fraufrau31/USB-C-Power-Meter/HW/Manufacturing/usb-c-power-meter-BOM.xlsx

Reference | Value | Description | Footprint | Qty | DNP | Mfr. No | DIGIKEY | FARNELL | MOUSER
C1,C2,C4,C6 | 100nF | C Ceramic, 100nF, 16V, ±10%, 0603 | Capacitor_SMD:C_0603_1608Metric | 4 |  | CC0603KRX7R7BB104 | 311-1088-1-ND | 2408501 | 603-CC603KRX7R7BB104
C3 | 10uF | C Ceramic, 10uF, 50V, ±10%, 1206 | Capacitor_SMD:C_1206_3216Metric | 1 |  | CL31A106KBHNNNE | 1276-2876-1-ND | 3013512 | 187-CL31A106KBHNNNE
C5 | 10uF | C Ceramic, 10uF, 16V, ±10%, 0805 | Capacitor_SMD:C_0805_2012Metric | 1 |  | CL21A106KOQNNNE | 1276-1096-1-ND | 3013453 | 187-CL21A106KOQNNNE
D1,D2 | BAT854CW | Dual Schottky diode, common anode on pin 1 | Package_TO_SOT_SMD:SOT-323_SC-70 | 2 |  | BAT854CW | 1727-1211-1-ND | 3912169 | 771-BAT854CW,135
D3 | BAT54GW | 30 V, 200 mA Schottky barrier diodes | Diode_SMD:D_SOD-123 | 1 |  | BAT54GWJ | 1727-7328-1-ND | 3439596 | 841-BAT54GWJ
J1,J2,J4 | USB4110 | Type C USB 2.0 Connector | Connector_USB:USB_C_Receptacle_GCT_USB4110 | 3 |  | USB4110-GF-A | 2073-USB4110-GF-A-1-ND | 3588206 | 640-USB4110-GF-A
J3 | Conn_01x04_Pin | Generic connector, single row, 01x04, script generated | Connector_PinHeader_2.54mm:PinHeader_1x04_P2.54mm_Vertical | 1 | DNP
R1,R2 | 5,1k | R, 5,1kOhms, ±1%, 0.1W, 1/10W, 0603 | Resistor_SMD:R_0603_1608Metric | 2 |  | RC0603FR-075K1L | 311-5.10KHRCT-ND | 3495881 | 603-RC0603FR-075K1L
R3,R4 | 27 | R, 27Ohms, ±1%, 0.1W, 1/10W, 0603 | Resistor_SMD:R_0603_1608Metric | 2 |  | RC0603FR-0727RL | 311-27.0HRCT-ND | 9238298 | 603-RC0603FR-0727RL
R5,R6,R7 | 10k | R, 10kOhms, ±1%, 0.1W, 1/10W, 0603 | Resistor_SMD:R_0603_1608Metric | 3 |  | RC0603FR-0710KL | 311-10.0KHRCT-ND | 9238603 | 603-RC0603FR-0710KL
R8 | 3,3k | R, 3,3kOhms, ±1%, 0.1W, 1/10W, 0603 | Resistor_SMD:R_0603_1608Metric | 1 |  | RC0603FR-073K3L | 311-3.30KHRCT-ND | 9238549 | 603-RC0603FR-073K3L
R9 | 0 | R, 0Ohms, ±1%, 0.1W, 1/10W, 0603 | Resistor_SMD:R_0603_1608Metric | 1 |  | RC0603JR-070RL | 311-0.0GRCT-ND | 9233130 | 603-RC0603JR-070RL
U1 | FT230XS | Full Speed USB to Basic UART, SSOP-16 | Package_SO:SSOP-16_3.9x4.9mm_P0.635mm | 1 |  | FT230XS-R | 768-1135-1-ND | 2081321 | 895-FT230XS-R
U2 | TLV709A33DBV | TLV709 150mA, 30V, 3.2μA Quiescent Current, Low-Dropout Linear Regulator | Package_TO_SOT_SMD:SOT-23-5 | 1 |  | TLV709A33DBV | 296-TLV709A33DBVRCT-ND | # | 595-TLV709A33DBVR
U3 | INA700AYWFR | 40-V 16-Bit I²C output digital power monitor in WCSP with EZShunt™ Technology | usb-c-power-meter:YWF0008A | 1 |  | INA700AYWFR | 296-INA700AYWFRCT-ND | # | 595-INA700AYWFR
U4 | ATtiny202-SS | 20MHz, 2kB Flash, 128B SRAM, 64B EEPROM, SOIC-8 | Package_SO:SOIC-8_3.9x4.9mm_P1.27mm | 1 |  | ATTINY202-SSFR | ATTINY202-SSFRCT-ND | 3630362 | 579-ATTINY202-SSFR
