fraufrau31/USB-C-Power-Meter/HW/3D/USB4110-GF-A.stp

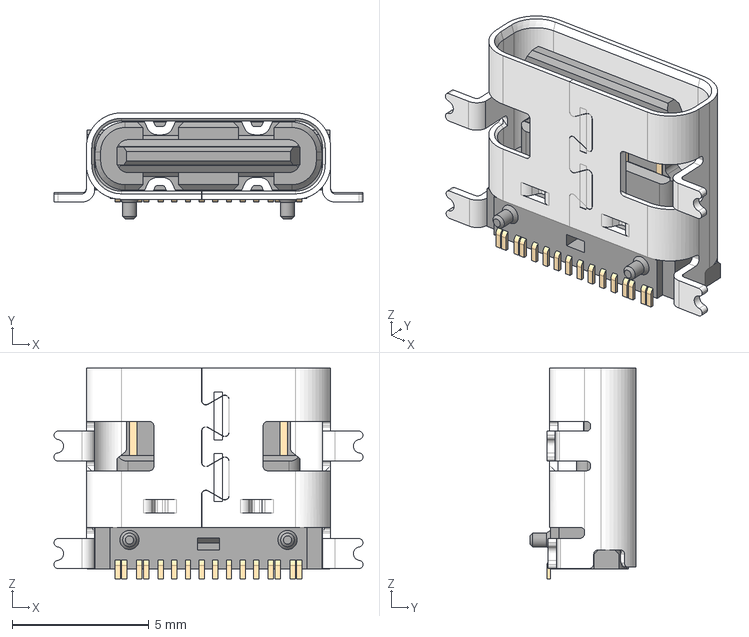
[picture p3: CAD file, 2024-12-28]
HW/3D/USB4110-GF-A.stp
11.3 x 3.89 x 7.70 mm
