fraufrau31/USB-C-Power-Meter/HW/3D/YWF0008A.stp

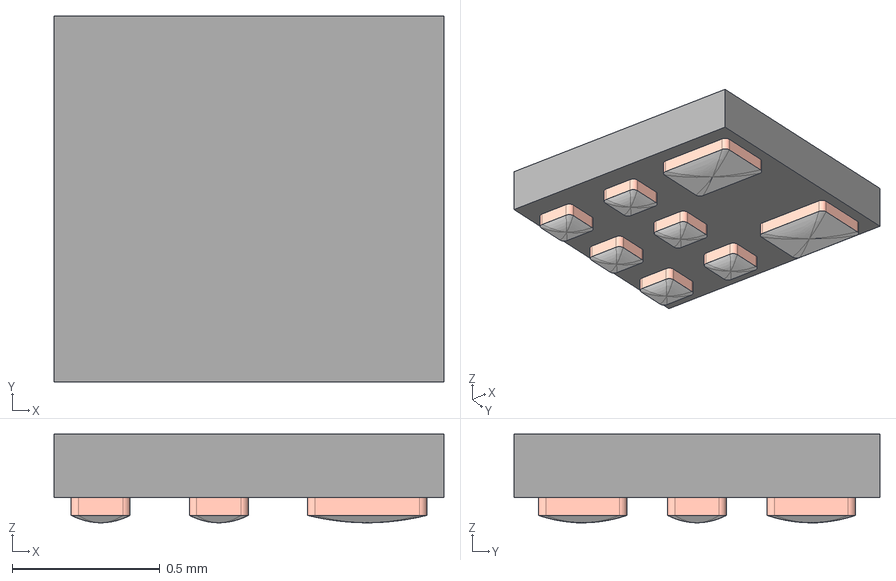
[picture p4: CAD file, 2024-12-28]
HW/3D/YWF0008A.stp
1.32 x 1.24 x 0.3 mm
SILICON_YWF0008A
CU_POST_YWF0008A_AF1 x 6
CAP_YWF0008A_AF0 x 6
CU_POST_YWF0008A_AF0 x 2
CAP_YWF0008A_AF1 x 2
