fraufrau31/USB-C-Power-Meter/Documentation/usb-c-power-meter-schematic.pdf

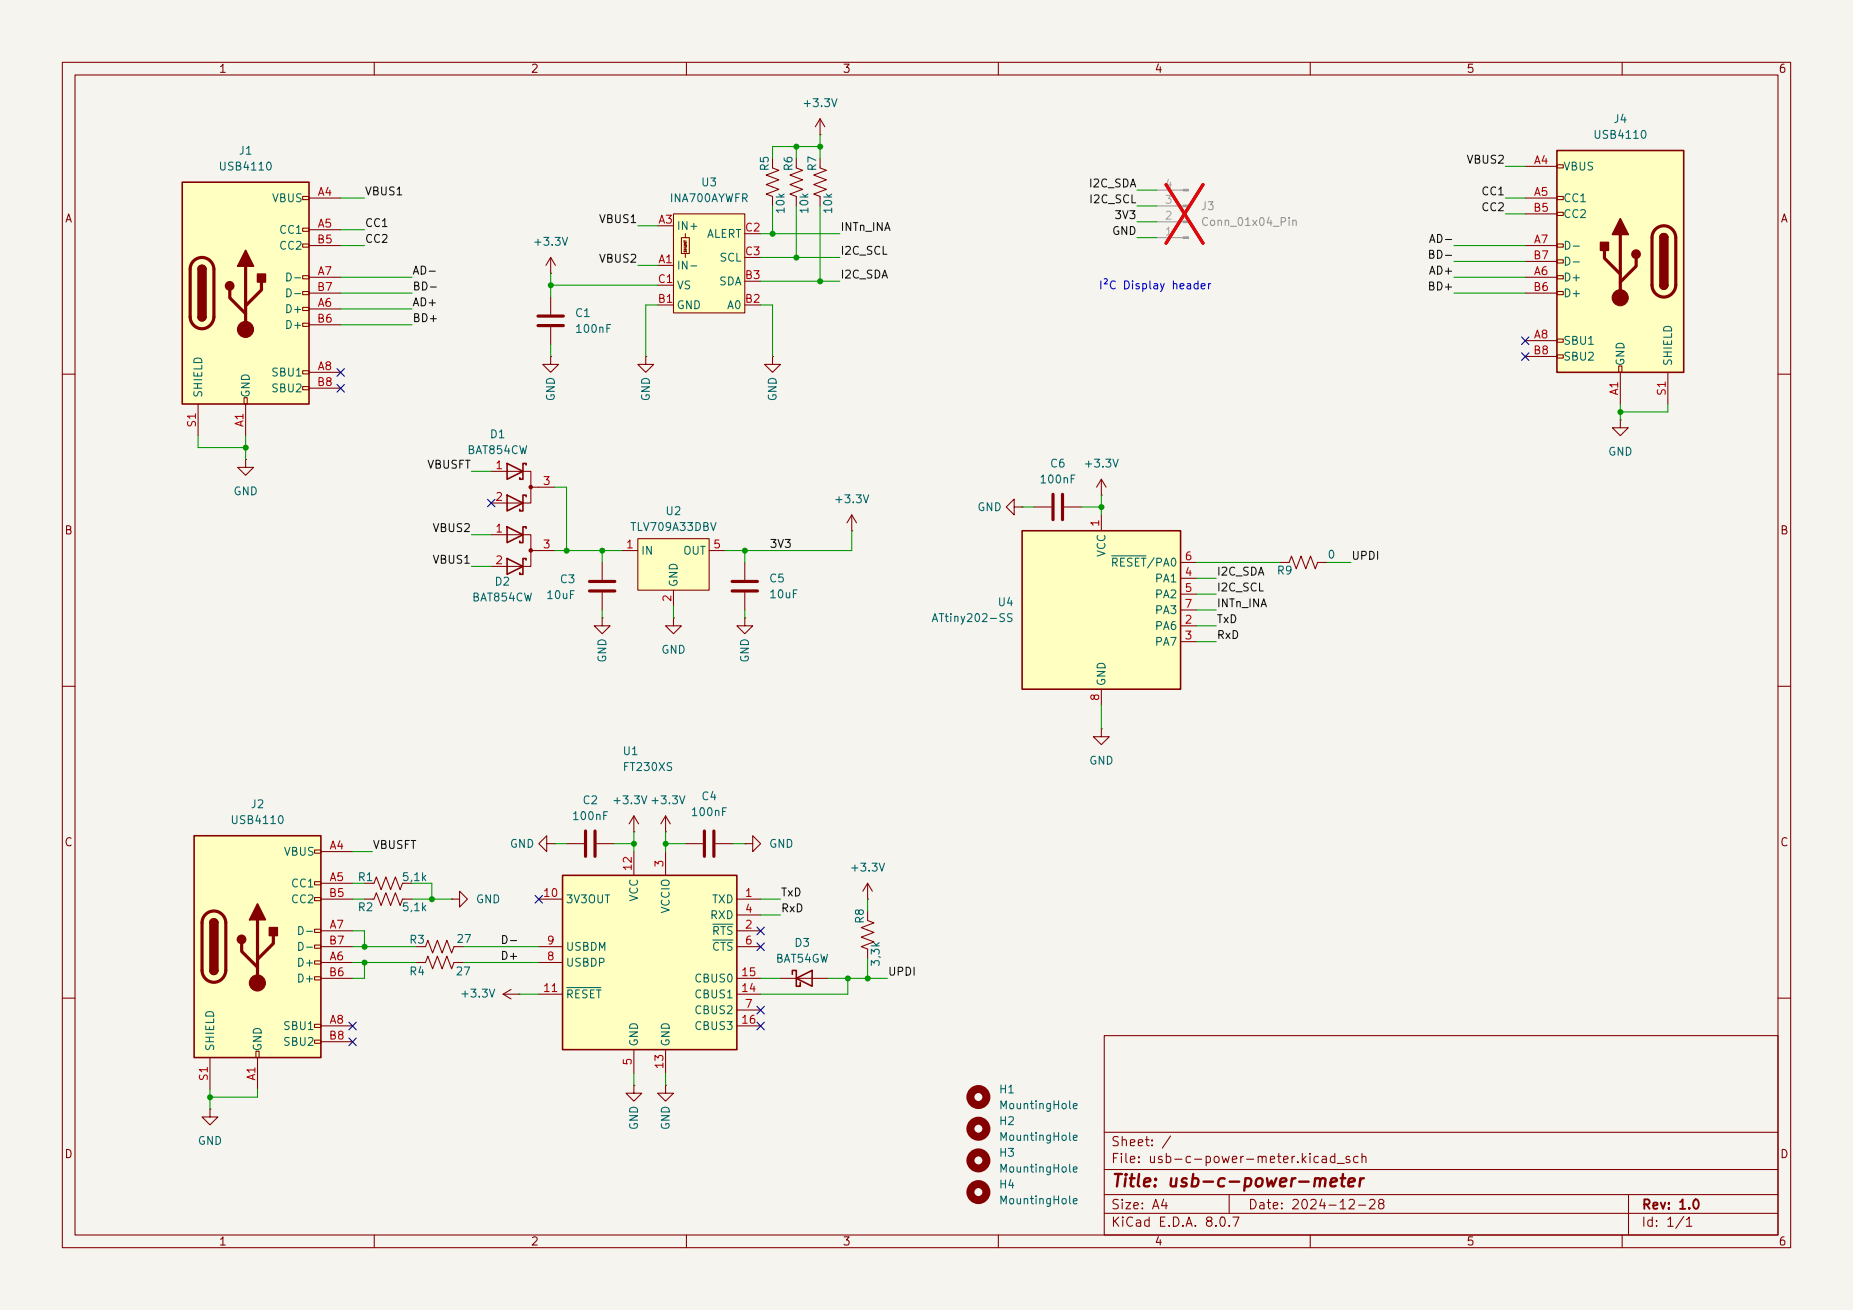
[picture p5: page 1]
