fraufrau31/USB-C-Power-Meter/HW/usb-c-power-meter.kicad_pcb

## KiCad design HW/usb-c-power-meter.kicad_pcb (2024-12-28)

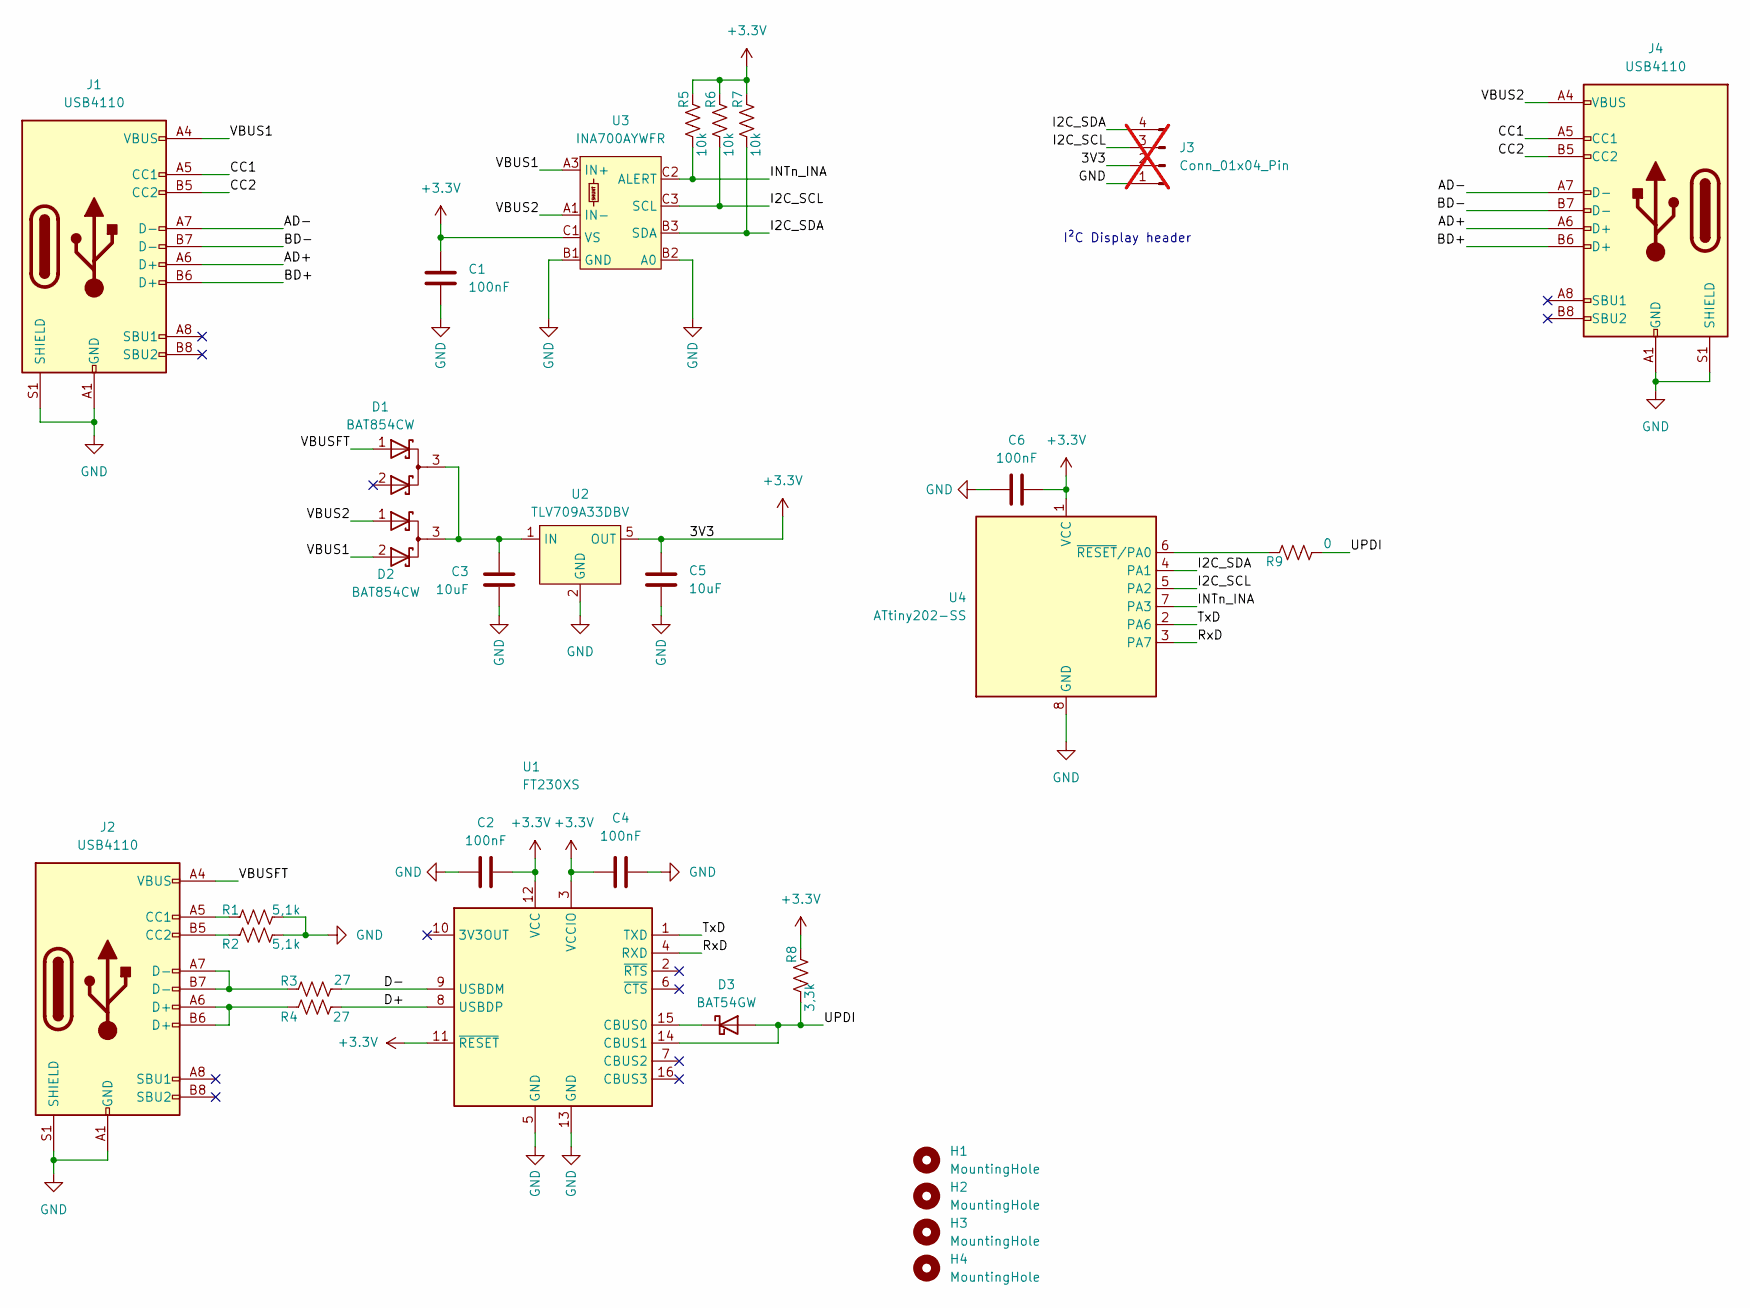
[picture p6: schematic usb-c-power-meter.kicad_sch]

Parts:
C1, C2, C4, C6: 100nF; C_0603_1608Metric; DIGIKEY 311-1088-1-ND
C3: 10uF; C_1206_3216Metric; DIGIKEY 1276-2876-1-ND
C5: 10uF; C_0805_2012Metric; DIGIKEY 1276-1096-1-ND
D1, D2: BAT854CW; SOT-323_SC-70; DIGIKEY 1727-1211-1-ND
D3: BAT54GW; D_SOD-123; DIGIKEY 1727-7328-1-ND
H1, H2, H3, H4: MountingHole; MountingHole_2.2mm_M2
J1, J2, J4: USB4110; USB_C_Receptacle_GCT_USB4110; DIGIKEY 2073-USB4110-GF-A-1-ND
J3: Conn_01x04_Pin; PinHeader_1x04_P2.54mm_Vertical; not fitted
R1, R2: 5,1k; R_0603_1608Metric; DIGIKEY 311-5.10KHRCT-ND
R3, R4: 27; R_0603_1608Metric; DIGIKEY 311-27.0HRCT-ND
R5, R6, R7: 10k; R_0603_1608Metric; DIGIKEY 311-10.0KHRCT-ND
R8: 3,3k; R_0603_1608Metric; DIGIKEY 311-3.30KHRCT-ND
R9: 0; R_0603_1608Metric; DIGIKEY 311-0.0GRCT-ND
U1: FT230XS; SSOP-16_3.9x4.9mm_P0.635mm; DIGIKEY 768-1135-1-ND
U2: TLV709A33DBV; SOT-23-5; DIGIKEY 296-TLV709A33DBVRCT-ND
U3: INA700AYWFR; YWF0008A; DIGIKEY 296-INA700AYWFRCT-ND
U4: ATtiny202-SS; SOIC-8_3.9x4.9mm_P1.27mm; DIGIKEY ATTINY202-SSFRCT-ND

Connections:
+3.3V: C1.1, C2.2, C4.1, C5.1, C6.2, J3.2, R5.2, R6.2, R7.2, R8.2, U1.3 (VCCIO), U1.11 (~RESET), U1.12 (VCC), U2.5 (OUT), U3.C1 (VS), U4.1 (VCC)
/AD+: J1.A6 (D+), J4.A6 (D+)
/AD-: J1.A7 (D-), J4.A7 (D-)
/BD+: J1.B6 (D+), J4.B6 (D+)
/BD-: J1.B7 (D-), J4.B7 (D-)
/CC1: J1.A5 (CC1), J4.A5 (CC1)
/CC2: J1.B5 (CC2), J4.B5 (CC2)
/D+: R4.1, U1.8 (USBDP)
/D-: R3.1, U1.9 (USBDM)
/I2C_SCL: J3.3, R6.1, U3.C3 (SCL), U4.5 (PA2)
/I2C_SDA: J3.4, R7.1, U3.B3 (SDA), U4.4 (PA1)
/INTn_INA: R5.1, U3.C2 (ALERT), U4.7 (PA3)
/RxD: U1.4 (RXD), U4.3 (PA7)
/TxD: U1.1 (TXD), U4.2 (PA6)
/UPDI: D3.2 (A), R8.1, R9.1, U1.14 (CBUS1)
/VBUS1: D2.2 (K), J1.A4 (VBUS), J1.A9 (VBUS), J1.B4 (VBUS), J1.B9 (VBUS), U3.A3 (IN+)
/VBUS2: D2.1 (K), J4.A4 (VBUS), J4.A9 (VBUS), J4.B4 (VBUS), J4.B9 (VBUS), U3.A1 (IN-)
/VBUSFT: D1.1 (K), J2.A4 (VBUS), J2.A9 (VBUS), J2.B4 (VBUS), J2.B9 (VBUS)
GND: C1.2, C2.1, C3.2, C4.2, C5.2, C6.1, J1.A1 (GND), J1.A12 (GND), J1.B1 (GND), J1.B12 (GND), J1.S1 (SHIELD), J2.A1 (GND), J2.A12 (GND), J2.B1 (GND), J2.B12 (GND), J2.S1 (SHIELD), J3.1, J4.A1 (GND), J4.A12 (GND), J4.B1 (GND), J4.B12 (GND), J4.S1 (SHIELD), R1.1, R2.1, U1.5 (GND), U1.13 (GND), U2.2 (GND), U3.B1 (GND), U3.B2 (A0), U4.8 (GND)
unnamed: C3.1, D1.3 (A), D2.3 (A), U2.1 (IN)
unnamed: D3.1 (K), U1.15 (CBUS0)
unnamed: J2.A5 (CC1), R1.2
unnamed: J2.B5 (CC2), R2.2
unnamed: J2.A6 (D+), J2.B6 (D+), R4.2
unnamed: J2.A7 (D-), J2.B7 (D-), R3.2
unnamed: R9.2, U4.6 (~RESET/PA0)

Notes on the sheet:
I²C Display header

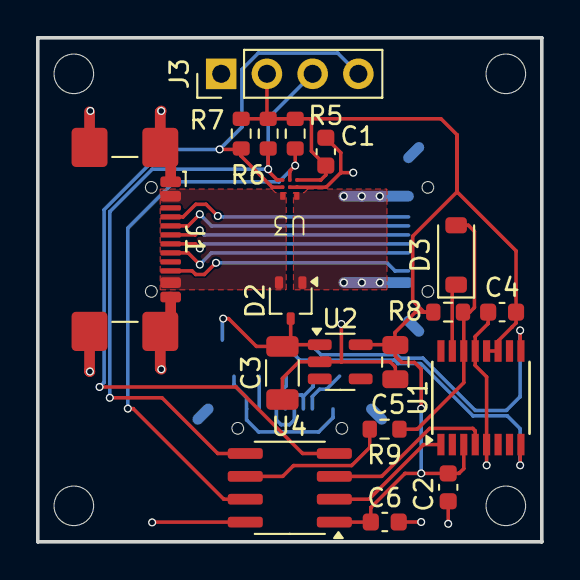
[picture p7: board usb-c-power-meter.kicad_pcb from above]

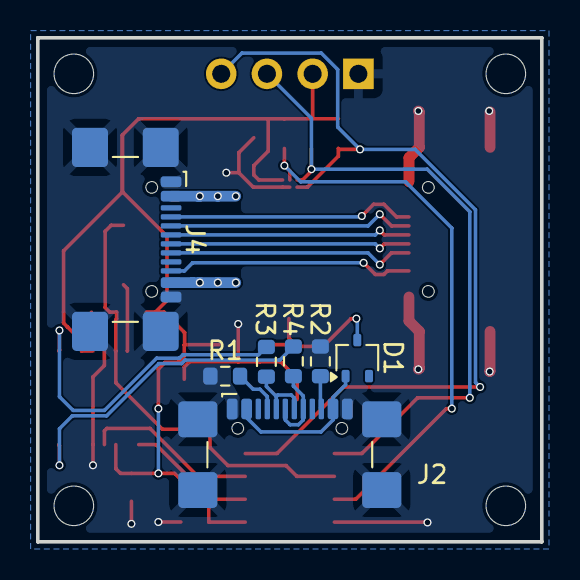
[picture p8: board usb-c-power-meter.kicad_pcb from below]

Board: 2 copper layers, 28.0 x 28.0 mm, 30 parts (7 on the bottom side), 26 nets.
