fraufrau31/USB-C-Power-Meter/(commit log)

2024-12-28 KiCAD project added
    [USB4110-GF-A.stp, YWF0008A.stp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]
2025-01-03 Repo organisation update
    [USB4110-GF-A.stp, YWF0008A.stp, usb-c-power-meter-BOM.xlsx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]
