fraufrau31/USB-C-Power-Meter/(notices)

Notices in the files:
HW/3D/USB4110-GF-A.stp:
author */ ('License CC BY-ND 4.0'),
